pique2233/Electronics-Design-Contest/README.md

# 📡 Electronics-Design-Contest




Typing SVG (https://git.io/typing-svg)
> 为2025年电子芯片设计大赛准备的项目介绍文档

---
## 项目背景
2025年电子芯片设计大赛为创新和技术应用提供平台，本项目整合单片机及视觉系统方案
## 视觉部分

<p float="left">
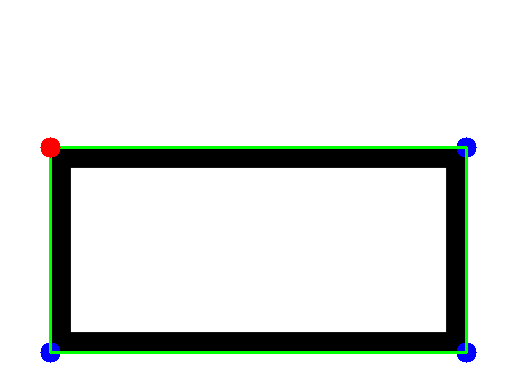
[picture p1: CV/rectangle_red_dot.gif]
  
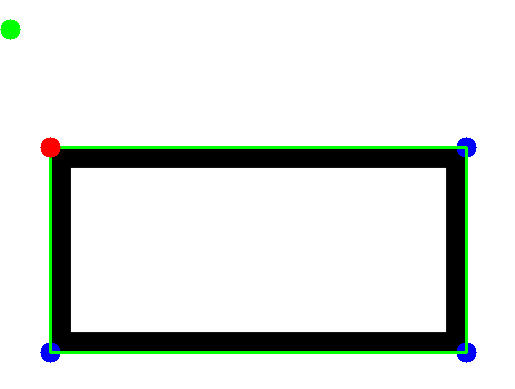
[picture p2: CV/red_dot_with_green_follower.gif]
  
</p>

### 目标
构建智能视觉系统，实现高效图像处理与深度学习应用。

### 主要内容
- **图像采集**：摄像头选型及驱动开发
- **图像处理**：边缘检测、目标识别及跟踪算法优化
- **深度学习**：模型训练部署（TensorFlow/PyTorch）

---

## 项目目录

- `/hardware`：硬件设计文档
- `/firmware`：单片机固件代码
- `/vision`：视觉算法与模型代码

---

> **备注**：持续更新中，欢迎贡献想法与建议！
