pique2233/Electronics-Design-Contest/CV/cropped_image.png

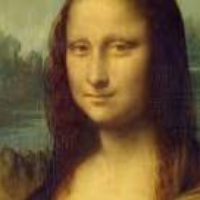
CV/cropped_image.png
