pique2233/Electronics-Design-Contest/CV/image.png

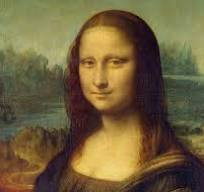
CV/image.png
