pique2233/Electronics-Design-Contest/CV/rotated_image.png

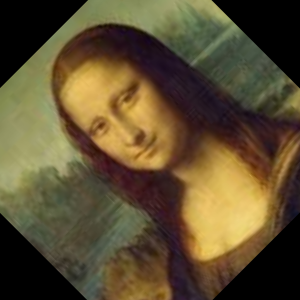
CV/rotated_image.png
