pique2233/Electronics-Design-Contest/(list of files, drawings)

Other design files:
Singlechip/diansai E 2 2/原理图文件/ProProject_【2023电赛】电赛激光瞄准.eprj
