pique2233/Electronics-Design-Contest/Singlechip/diansai E 2 2/绿色nuedc-STM/Core/Src/main.c

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
/* Includes ------------------------------------------------------------------*/
#include "main.h"
#include "tim.h"
#include "usart.h"
#include "gpio.h"

/* USER CODE BEGIN Includes */

#include "stdio.h"
#include "oled.h"
#include "paixu.h"
#include "pid.h"
/* USER CODE END Includes */

/* USER CODE BEGIN PTD */
//uint8_t rx_data[1];
uint8_t g_ucUsart1ReceiveData; 


 uint8_t state = 0;
uint8_t g_ucaUsart2ReceiveBuffer[20];//保存串口接收有效数据的数组
uint8_t g_ucUsart1ReceivCounter=0;//串口接收计数值
uint8_t g_ucUsart1ReceiveCompletionFlag;//串口二接收完成标志位 1:接收完成 可以进行处理 0:接收未完成或者接受中

uint8_t key_flag=0;

//extern ServoState gensui;

//extern tPid pidFollow_x;    //定距离跟随PID
//extern tPid pidFollow_y;

extern Loc_PID Loc_pid; //存放PID算法所需要的数据
extern Spe_PID Spe_pid;
uint8_t test=0;
#define speed_move  100//100
/* USER CODE END PTD */


void SystemClock_Config(void);
/**
  * @brief  The application entry point.
  * @retval int
  */
int main(void)
{
  /* USER CODE BEGIN 1 */
uint8_t string[20];
  uint8_t  flag = 1;
    int i = 0;
  /* USER CODE END 1 */

  /* MCU Configuration--------------------------------------------------------*/

  /* Reset of all peripherals, Initializes the Flash interface and the Systick. */
  HAL_Init();

  /* Configure the system clock */
  SystemClock_Config();

  /* Initialize all configured peripherals */
  MX_GPIO_Init();
  MX_TIM1_Init();
  MX_USART1_UART_Init();
  MX_TIM3_Init();
  MX_TIM2_Init();
  /* USER CODE BEGIN 2 */
    PID_Init();
	OLED_Init(); //初始化OLED
    OLED_Clear();//清屏
		
   HAL_UART_Receive_IT(&huart1, &g_ucUsart1ReceiveData, 1);//串口接收中断
	
	
		//舵机
//  HAL_TIM_PWM_Start(&htim1,TIM_CHANNEL_1);//开启定时器1 通道1 PWM输出
//  HAL_TIM_PWM_Start(&htim1,TIM_CHANNEL_4);//开启定时器1 通道4 PWM输出
    HAL_TIM_PWM_Start(&htim3,TIM_CHANNEL_1);//开启定时器1 通道4 PWM输出
    HAL_TIM_PWM_Start(&htim2,TIM_CHANNEL_4);//开启定时器1 通道4 PWM输出
   __HAL_TIM_SET_COMPARE(&htim3, TIM_CHANNEL_1, 950);  // 竖直PA6 750
   __HAL_TIM_SET_COMPARE(&htim2, TIM_CHANNEL_4, 750);  


    

/////////////////////////////////////////////////////////////////测试区



/////////////////////////////////////////////////////////////////测试区

  /* USER CODE END 2 */

  /* Infinite loop */
  /* USER CODE BEGIN WHILE */
  while (1)
  { 

      
      
      
      
 //test=HAL_GPIO_ReadPin(GPIOC,GPIO_PIN_14);    
 

   __HAL_TIM_SET_COMPARE(&htim3, TIM_CHANNEL_1, Spe_PID_output(g_ucaUsart2ReceiveBuffer[3],g_ucaUsart2ReceiveBuffer[5]));  //g_ucaUsart2ReceiveBuffer[5]水平 PA11 750PID_realize(&pidFollow,float Green_actual_val,float Red_target_val)
//    printf("1X:%d\n 2X:%d\n %d\n  ",g_ucaUsart2ReceiveBuffer[3],g_ucaUsart2ReceiveBuffer[5],Spe_PID_output(g_ucaUsart2ReceiveBuffer[3],g_ucaUsart2ReceiveBuffer[5]));
      
    printf("\r\n");
      __HAL_TIM_SET_COMPARE(&htim2, TIM_CHANNEL_4, Loc_PID_output (g_ucaUsart2ReceiveBuffer[2],g_ucaUsart2ReceiveBuffer[4]));  //g_ucaUsart2ReceiveBuffer[4])水平 PA11 750PID_realize(&pidFollow,float Green_actual_val,float Red_target_val)
//     printf("Y:%d\r\n",Loc_PID_output (g_ucaUsart2ReceiveBuffer[2],g_ucaUsart2ReceiveBuffer[4]));
    printf("1Y:%d\n 2Y:%d\n %d\n  ",abs(g_ucaUsart2ReceiveBuffer[2]-g_ucaUsart2ReceiveBuffer[4]),abs(g_ucaUsart2ReceiveBuffer[3]-g_ucaUsart2ReceiveBuffer[5]),Spe_PID_output(g_ucaUsart2ReceiveBuffer[2],g_ucaUsart2ReceiveBuffer[4]));

//if((abs(g_ucaUsart2ReceiveBuffer[2]-g_ucaUsart2ReceiveBuffer[4])<20&&abs(g_ucaUsart2ReceiveBuffer[3]-g_ucaUsart2ReceiveBuffer[5])<20)){
//            i++;
//          flag = 0;

//    }

//test=1;

}        



//shunshizhen_4paixv_change();
//while (HAL_GPIO_ReadPin(GPIOC,GPIO_PIN_14 )==RESET)
//{	
//  
//}
//          
      
//      
//      /*PC15 低片平触发，复位*/
//        if(key_flag==2)
//      {
//      slow_motion (250, 0, 240, 0,0);
//          
//      key_flag=0;
//       }
//      shunshizhen_4paixv_change();
//        if(key_flag==3)
//      {
//      shunshizhen_4paixv_change();
//          change_pwmset();
//      key_flag=0;
//       }
//      
////		
//            
//        
//				
//				
//				for(int i=0;i<20;i++) g_ucaUsart2ReceiveBuffer[i]=0x00;//清空数组
//				g_ucUsart1ReceiveCompletionFlag = 0;//使用数据后置为0
//			}
//		
//		
//		
///////////////////////////////////////////////////////////////////测试区 随意删除不影响系统		
//		
//HAL_GPIO_TogglePin(GPIOC,GPIO_PIN_13);
//		

		//test=0;
		
		
/////////////////////////////////////////////////////////////////测试区
    /* USER CODE END WHILE */

    /* USER CODE BEGIN 3 */
  }
  /* USER CODE END 3 */


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
/* USER CODE BEGIN 4 */
//////////////////////////////////////////////////////////////////////////////

/*串口中断回调函数*/
void HAL_UART_RxCpltCallback(UART_HandleTypeDef *huart)
{
  if (huart == &huart1) 
  {
  
		//
		usartCamera_Receive_Data(g_ucUsart1ReceiveData);//通信处理功能
		
  }
	 HAL_UART_Receive_IT(&huart1, &g_ucUsart1ReceiveData, 1);
}






void usartCamera_Receive_Data(uint8_t data)
{
//	static uint8_t state = 0;
	if(state==0&&data==0xA5) //第一个是不是帧头0xA5
	{
		state=1;
		g_ucaUsart2ReceiveBuffer[g_ucUsart1ReceivCounter++]=data;
		HAL_UART_Receive_IT(&huart1,&g_ucUsart1ReceiveData,1);  //串口二接收数据
	}
	else if(state==1&&data==0xA6) //第二个是不是帧头0xA6
	{
		state=2;
		g_ucaUsart2ReceiveBuffer[g_ucUsart1ReceivCounter++]=data;
		HAL_UART_Receive_IT(&huart1,&g_ucUsart1ReceiveData,1);  //串口二接收数据		
	}
	else if(state==2)//然后确定开头是0XA5 0XA6 就开始接收
	{
		g_ucaUsart2ReceiveBuffer[g_ucUsart1ReceivCounter++]=data;
		if(g_ucUsart1ReceivCounter>14||data==0x5B) state=3;  //接收大于9个或者接收到帧尾0X5B 就置位状态三
		HAL_UART_Receive_IT(&huart1,&g_ucUsart1ReceiveData,1);  //串口二接收数据		
	}
	else if(state==3) //状态三
	{
		if(g_ucaUsart2ReceiveBuffer[g_ucUsart1ReceivCounter-1] == 0x5B)  //最后一个是不是0x5B帧尾
		{
			state = 0;//这里就可以处理数据了、处理完记得清空数组和重置标志位与计数值
			//比如根据数据设置红外旋转偏移状态
//			if(g_ucMode == 7)
//			{
				//1.设置快速 慢速右边 左边&&g_ucaUsart2ReceiveBuffer[4]==1
				
				/**
				 if(g_ucaUsart2ReceiveBuffer[6]==0&&g_ucaUsart2ReceiveBuffer[5]==0&&g_ucaUsart2ReceiveBuffer[3]==0&&g_ucaUsart2ReceiveBuffer[2]==0)
				 {g_cThisState=0;//前进
				 g_lHW_State=00200;
				 }
				 if(g_ucaUsart2ReceiveBuffer[6]==0&&g_ucaUsart2ReceiveBuffer[5]==1&&g_ucaUsart2ReceiveBuffer[3]==0&&g_ucaUsart2ReceiveBuffer[2]==0)
				 {g_cThisState=-1;//应该右转
				 g_lHW_State=00210;
				 }
				 if(g_ucaUsart2ReceiveBuffer[6]==1&&g_ucaUsart2ReceiveBuffer[5]==0&&g_ucaUsart2ReceiveBuffer[3]==0&&g_ucaUsart2ReceiveBuffer[2]==0)
				 {g_cThisState=-2;//快速右转
				 g_lHW_State=00201;
				 }
				 if(g_ucaUsart2ReceiveBuffer[6]==1&&g_ucaUsart2ReceiveBuffer[5]==1&&g_ucaUsart2ReceiveBuffer[3]==0&&g_ucaUsart2ReceiveBuffer[2]==0)
				 {g_cThisState=-3;//快速右转
				 g_lHW_State=00211;
				 }
				 if(g_ucaUsart2ReceiveBuffer[6]==0&&g_ucaUsart2ReceiveBuffer[5]==0&&g_ucaUsart2ReceiveBuffer[3]==1&&g_ucaUsart2ReceiveBuffer[2]==0)
				 {g_cThisState=1;//应该左转
				 g_lHW_State=01200;
				 }
                 if(g_ucaUsart2ReceiveBuffer[6]==0&&g_ucaUsart2ReceiveBuffer[5]==0&&g_ucaUsart2ReceiveBuffer[3]==0&&g_ucaUsart2ReceiveBuffer[2]==1)
				 {g_cThisState=2;//快速左转
				 g_lHW_State=10200;
				 }
                 if(g_ucaUsart2ReceiveBuffer[6]==0&&g_ucaUsart2ReceiveBuffer[5]==0&&g_ucaUsart2ReceiveBuffer[3]==1&&g_ucaUsart2ReceiveBuffer[2]==1)
				 {g_cThisState=3;//快速左转
				 g_lHW_State=1;
				 }
				 //如果都是红线 都是1 就置为相应变量 表示停止运行等
				 if(g_ucaUsart2ReceiveBuffer[6]==1&&g_ucaUsart2ReceiveBuffer[5]==1&&g_ucaUsart2ReceiveBuffer[4]==1&&g_ucaUsart2ReceiveBuffer[3]==1&&g_ucaUsart2ReceiveBuffer[2]==1)g_lHW_State=11111;
				 
				 //五个点都没有的时候认为走到了尽头
				 if(g_ucaUsart2ReceiveBuffer[6]==0&&g_ucaUsart2ReceiveBuffer[5]==0&&g_ucaUsart2ReceiveBuffer[4]==0&&g_ucaUsart2ReceiveBuffer[3]==0&&g_ucaUsart2ReceiveBuffer[2]==0)g_lHW_State=0;
				 //只有中间是红线时候
				 if(g_ucaUsart2ReceiveBuffer[6]==0&&g_ucaUsart2ReceiveBuffer[5]==0&&g_ucaUsart2ReceiveBuffer[4]==1&&g_ucaUsart2ReceiveBuffer[3]==0&&g_ucaUsart2ReceiveBuffer[2]==0)g_lHW_State=100;
				 
				 **/
				//2.然后清空数组
//				for(int i=0;i<10;i++) g_ucaUsart2ReceiveBuffer[i]=0x00;//清空数组
				g_ucUsart1ReceiveCompletionFlag = 1;
				//3.然后开始接收 
				HAL_UART_Receive_IT(&huart1,&g_ucUsart1ReceiveData,1);  //串口二接收数据
//			}
		}
		else //不是帧尾说明通信错误重新开始接收
		{
			state=0;
			g_ucUsart1ReceivCounter =0;
			//for(int i=0;i<10;i++) g_ucaUsart2ReceiveBuffer[i]=0x00;//清空数组
			g_ucUsart1ReceiveCompletionFlag = 0;
			HAL_UART_Receive_IT(&huart1,&g_ucUsart1ReceiveData,1);  //串口二接收数据
		}
	}
	else
	{	//其他异常清空
		state=0;
		g_ucUsart1ReceivCounter =0;
		//for(int i=0;i<10;i++) g_ucaUsart2ReceiveBuffer[i]=0x00;//清空数组
		g_ucUsart1ReceiveCompletionFlag = 0;
		HAL_UART_Receive_IT(&huart1,&g_ucUsart1ReceiveData,1);  //串口二接收数据
	}
}











/*PC15 低片平触发*/
/*扫框程序*/
//void HAL_GPIO_EXTI_Callback(uint16_t GPIO_Pin)
//{

//if(GPIO_Pin == KEY2_Pin){//判断一下那个引脚触发中断
////这里编写触发中断后要执行的程序
//	
//	  slow_motion (0, -250, 0, 0,1);
//      slow_motion (-250, -250, 0, 500,1);
//      slow_motion (-250, 250, 500, 500,1);
//      slow_motion (250, 250, 500, 0,1);
//      slow_motion (250, 0, 0, 0,1);
////	printf("key");
//	
//HAL_GPIO_TogglePin(GPIOC,GPIO_PIN_13);//切换LED GPIO状态
//}
//}







/* USER CODE END 4 */
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
