pique2233/Electronics-Design-Contest/Singlechip/diansai E 2 2/nuedc-STM/Core/Inc/main.h

#define LED_Pin GPIO_PIN_13
#define LED_GPIO_Port GPIOC
#define KEY1_Pin GPIO_PIN_14
#define KEY1_GPIO_Port GPIOC
#define KEY1_EXTI_IRQn EXTI15_10_IRQn
#define KEY2_Pin GPIO_PIN_15
#define KEY2_GPIO_Port GPIOC
#define KEY2_EXTI_IRQn EXTI15_10_IRQn
#define KEY3_Pin GPIO_PIN_1
#define KEY3_GPIO_Port GPIOA
#define KEY3_EXTI_IRQn EXTI1_IRQn
#define KEY4_Pin GPIO_PIN_2
#define KEY4_GPIO_Port GPIOA
#define KEY4_EXTI_IRQn EXTI2_IRQn
#define OLED_SDA_Pin GPIO_PIN_12
#define OLED_SDA_GPIO_Port GPIOB
#define OLED_SCL_Pin GPIO_PIN_15
#define OLED_SCL_GPIO_Port GPIOA
