pique2233/Electronics-Design-Contest/Singlechip/diansai E 2 2/nuedc-STM/Core/Inc/oled_page.h

#ifndef __OLED_PAGE_H
#define __OLED_PAGE_H

#include "oled.h"
#include "main.h" 
#include "oled_page.h"
#include "stdio.h"












uint8_t oled_change(void);
uint8_t page_start(void);
uint8_t page_1(void);    
uint8_t page_2(void);
uint8_t page_DEBUG(void);

	uint8_t page_1_2(void);
	uint8_t page_1_3(void);
	uint8_t page_1_4(void);
	
	uint8_t page_2_1(void);	
	uint8_t page_2_2(void);
	uint8_t page_2_3(void);

	
#endif
