pique2233/Electronics-Design-Contest/Singlechip/diansai E 2 2/nuedc-STM/Core/Inc/tim.h

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
/* Define to prevent recursive inclusion -------------------------------------*/
#ifndef __TIM_H__
#define __TIM_H__

#ifdef __cplusplus
extern "C" {
#endif

/* Includes ------------------------------------------------------------------*/
#include "main.h"

extern TIM_HandleTypeDef htim1;

extern TIM_HandleTypeDef htim3;

void MX_TIM1_Init(void);
void MX_TIM3_Init(void);

void HAL_TIM_MspPostInit(TIM_HandleTypeDef *htim);

/* USER CODE BEGIN Prototypes */
float pwm_set_red(double x,double y);
void slow_motion (double x1,double x2,double y1,double y2,int time);
void delay_us(uint16_t nus);
double calculateDistance(int x1, int y1, int x2, int y2);
void moveToPoint(int targetX, int targetY, int currentX, int currentY) ;
void xie_move(int pointAX,int pointAY,int pointBX,int pointBY,uint16_t time) 
 ;

/* USER CODE END Prototypes */

#ifdef __cplusplus
}
#endif

#endif /* __TIM_H__ */
