pique2233/Electronics-Design-Contest/(commit log)

2025-04-27 update infor
    [ProProject_【2023电赛】电赛激光瞄准.eprj]
2025-05-08 update cv2
    [green_dot_coordinates.xlsx, red_dot_coordinates.xlsx]
2025-07-13 update cv
    [red_dot_coordinates2.xlsx]
