pique2233/Electronics-Design-Contest/(notices)

Notices in the files:
Singlechip/diansai E 2 2/nuedc-STM/Core/Inc/main.h:
Copyright (c) 2023 STMicroelectronics.
All rights reserved.
This software is licensed under terms that can be found in the LICENSE file
